lalitya12/Keus-Line-Follower-Bot/Kriti2026_Team2613_main (2).pdf

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

Kriti 2026 | Bot Design Challenge | Team ID: 2613

Executive Summary

This report presents the complete design, development, and implementation of a fully

autonomous ground rover for the Kriti 2026 Bot Design Challenge, sponsored by Keus

Smart Home. The system is engineered as a three-tier embedded architecture.

Tier 1 Arduino Uno handles real-time navigation via an eight-sensor IR array (ve

for line following, three for obstacle detection) and dual-mode obstacle avoidance (side

IRs and front IR). Tier 2 ESP32 DevModule runs a FreeRTOS dual-core percep-

tion engine managing MPU6050-based IMU-guided turning, ultrasonic radar sweep, and

camera servo positioning. Tier 3 Raspberry Pi 5 executes a ve-model machine

learning ensemble comprising YOLOv8-nano, MobileNetV3-Small embeddings, dlib face

recognition, pyzbar QR decoding, and Tesseract OCR, with results streamed in real time

to a Flask-SocketIO web dashboard.

The rover navigates a 15 ft × 20 ft oor-marked arena, follows a symmetric two-track

path with junction-aware state tracking, dynamically avoids a 250 mm cube obstacle

using gyroscope-guided 90° turns, and identies all 16 A4-format image cards. The

live operator dashboard displays camera feed, identied targets against a running 0/16

counter, timestamped logs, and a competition timer entirely over Wi-Fi, with no cloud

dependency. All computation is fully onboard.

1 | Keus Bot

## Contents

1 Problem Statement Overview | 4
2 System Architecture | 7
3 Hardware Design | 10
4 Navigation and Mobility | 15
5 Perception System | 19
6 Image Recognition Pipeline | 22

7 Communication and Web Dashboard | 25
8 Software Architecture | 27
9 System Autonomy and Execution | 29
10 Testing and Validation | 31
11 Firmware Code Walkthrough | 32
12 Conclusion | 35
A Key System Parameters | 37
B Software Requirements Files | 38

## 1 Problem Statement Overview

### 1.1 Challenge Introduction

The Kriti 2026 Bot Design Challenge requires teams to build a fully autonomous rover that navigates a predened arena while performing real-time image detection and identication without any remote control or cloud processing.

The rover must traverse a symmetric oor-marked path from point A to point B (and back in the second run), identify 16 image cards placed throughout the arena, and transmit all recognition results wirelessly to an operator laptop via a live web interface. Each team receives two attempts of up to 5 minutes; the best run is scored.

### 1.2 Arena Layout

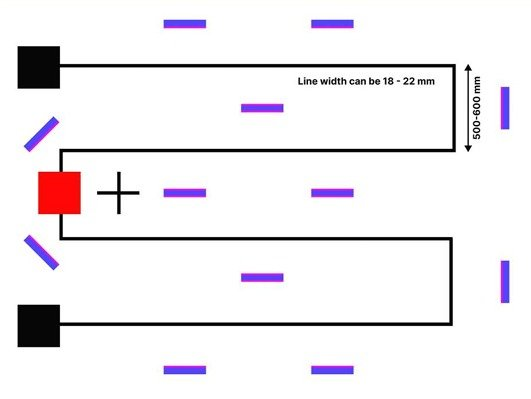
[picture p1: figure]

Figure 1. Actual arena layout (15 ft × 20 ft) Kriti 2026 Bot Design Challenge. Black path with 1822 mm line width; red obstacle (250 mm cube); purple image cards at periphery, centre corridor, and at 45° near obstacle; track segments of 500600 mm width.

### 1.3 Key Constraints

Table 1. Technical and operational constraints

Category | Constraint | Details
Technical | Max dimensions | 25 cm × 25 cm × 25 cm at all times
| Max weight | 3 kg
| Run duration | 5 minutes per run
| Power source | Onboard battery only; no external supply
O-path | Per instance | Must rejoin path within 10 seconds
| Total per run | ≤ 30 seconds o-path per run
Hardware | Controllers | Arduino, ESP32/ESP8266, Raspberry Pi only
| Forbidden | Jetson Nano, external SBCs, cloud/laptop compute
| Peripherals | Cameras, sensors, motor drivers permitted
Task | Image cards | Exactly 16; any identication order
| End condition | Reach end position after all identications

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

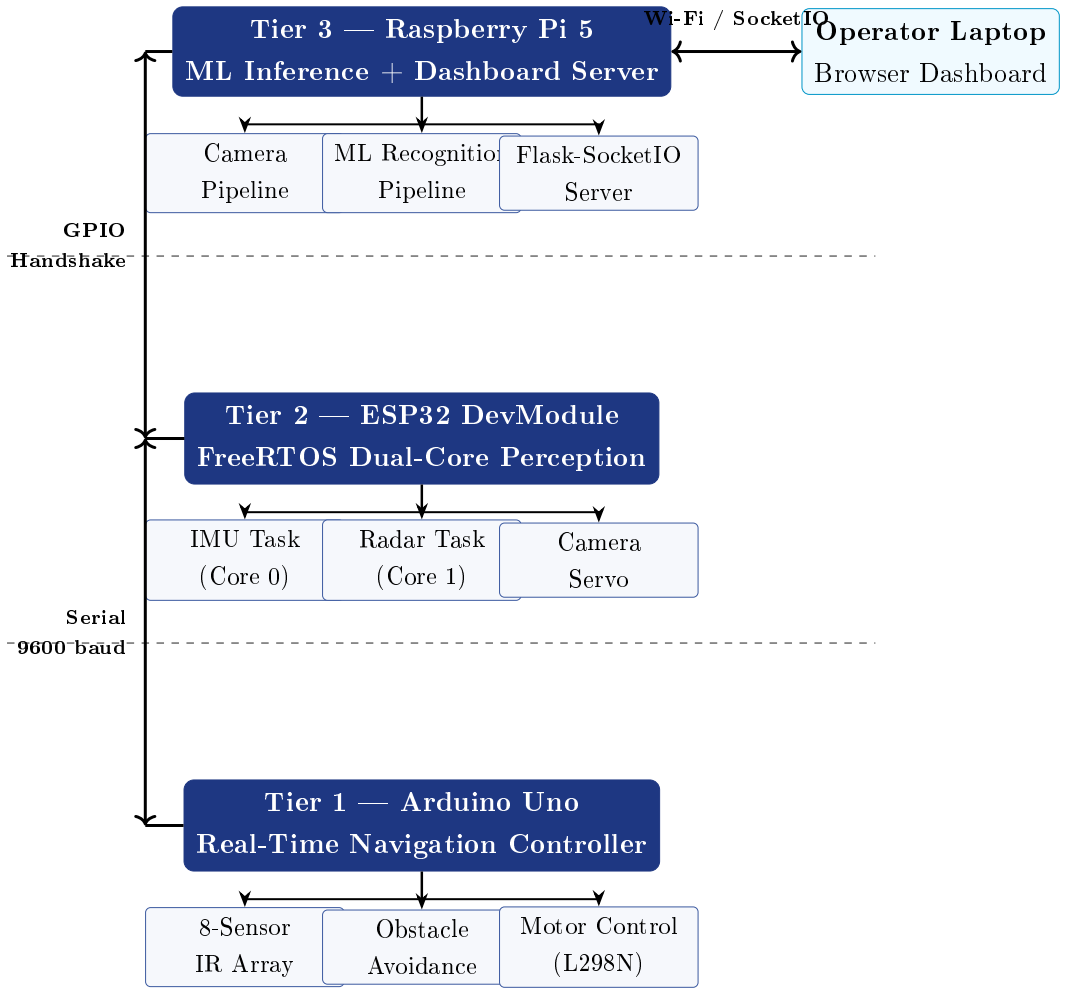
[picture p2: figure]

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

## 3 Hardware Design

### 3.1 Chassis and Mechanical Design

The rover uses a two-layer laser-cut 3 mm acrylic chassis with brass standos separating the layers for double-deck component mounting. The chassis ts within the 25 cm × 25 cm × 25 cm competition envelope at all times.

Bottom layer: DC gear motors (Ö2) with rubber wheels; array of 5 IR sen-
| sors (bottom-facing, line following); 12 V LiPo battery compartment (motor power supply).

Top layer: Arduino Uno; ESP32 DevModule; L298N motor driver; mini bread-
| boards; MPU6050 IMU module; wiring harness; power bank (RPi supply) and Li-ion 18650 cell (ESP32 supply) secured to top platform.

Servo mounts: Radar servo (30°150° sweep with front ultrasonic) and Pi Camera
| Module 3 pan servo mounted centrally on the top layer.
Front bracket: Front-facing HC-SR04 ultrasonic sensor and front IR sensor for
| obstacle detection, mounted at obstacle-detection height.
Side brackets: Left and right HC-SR04 ultrasonic sensors and side IR sensors
| (obsL, obsR) mounted on left and right anks at obstacle-detection height.

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

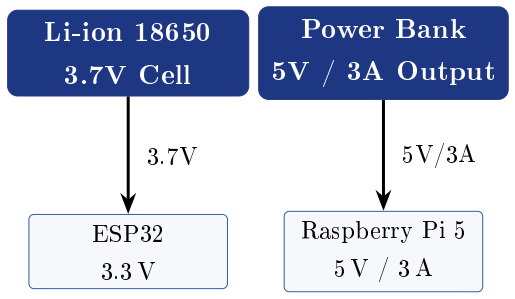
[picture p3: figure]
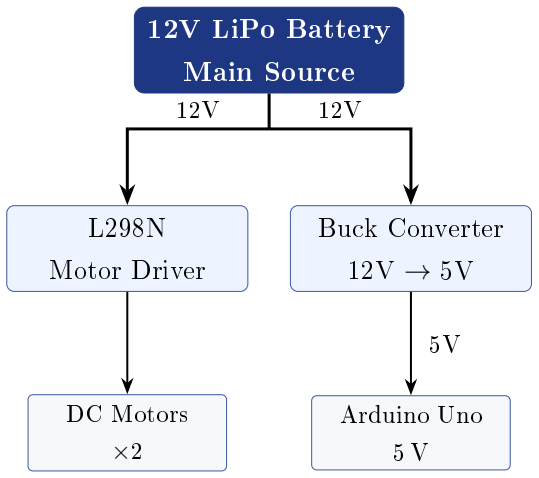
[picture p4: figure]

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

## 4 Navigation and Mobility

### 4.1 Line Following Algorithm

Five downward-facing IR sensors are arranged LL L M R RR across the path width. The Arduino evaluates them each loop iteration using a strict priority cascade: the rst matching condition determines the motor command for that cycle.

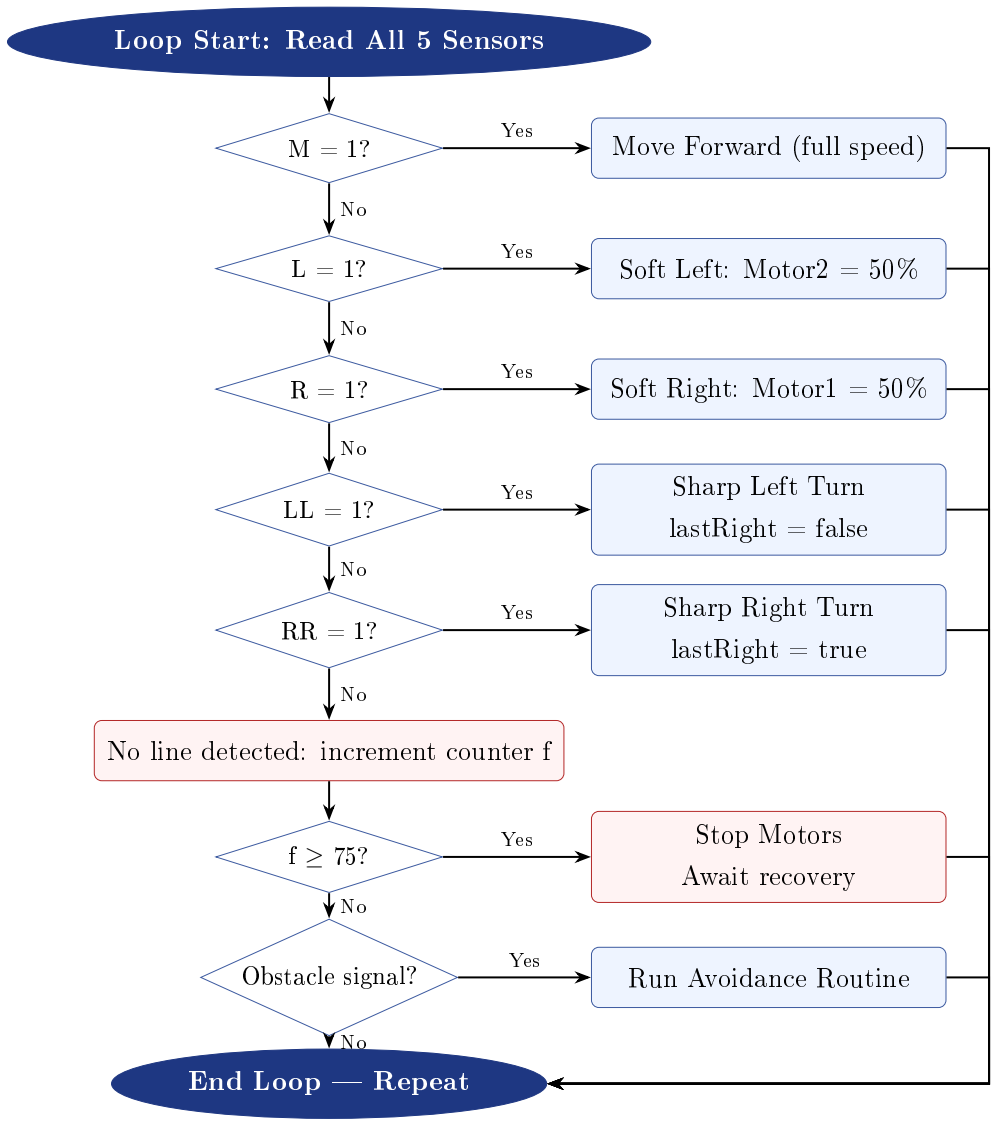
[picture p5: figure]
Loop Start: Read All 5 Sensors; No line detected: increment counter f; Obstacle signal?; End Loop  Repeat; Move Forward (full speed); Soft Left: Motor2 = 50%; Soft Right: Motor1 = 50%; Sharp Left Turn; lastRight = false; Sharp Right Turn; lastRight = true; Stop Motors; Await recovery; Run Avoidance Routine; Yes

Figure 4. Line following priority cascade with lost-line handler and obstacle check.

The lastRight ag is updated at LL/RR junctions. It stores the most recent sharpturn direction and drives all subsequent obstacle avoidance logic to ensure correct sideselection for path re-entry.

### 4.2 Obstacle Avoidance Side IR Triggered

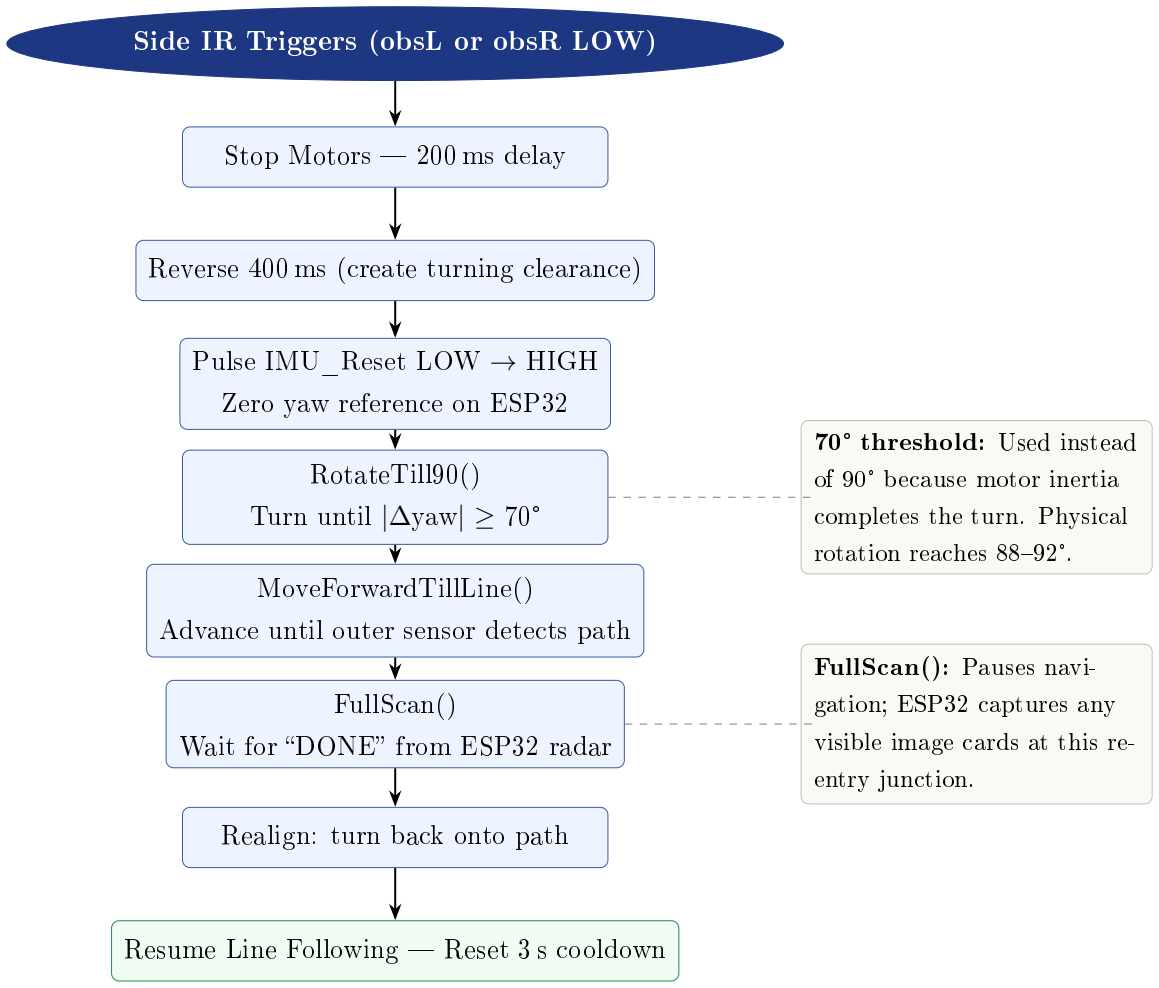
[picture p6: figure]
Side IR Triggers (obsL or obsR LOW); Stop Motors  200 ms delay; Pulse IMU_Reset LOW → HIGH; Zero yaw reference on ESP32; RotateTill90(); Turn until |∆yaw| ≥ 70°; MoveForwardTillLine(); Advance until outer sensor detects path; FullScan(); Wait for DONE from ESP32 radar; Realign: turn back onto path; threshold: Used instead; because motor inertia; completes the turn. Physical; rotation reaches 8892°.; FullScan(): Pauses navi-; gation; ESP32 captures any; visible image cards at this re-; entry junction.

Reverse 400 ms (create turning clearance)

Resume Line Following Reset 3 s cooldown

Figure 5. Side obstacle avoidance routine (obsAvoid).

### 4.3 Obstacle Avoidance Front IR Triggered

Front IR: Obstacle Detected from ESP32 Serial

Stop Motors

Turn 1: Rotate 90° in lastRight direction

Forward 1000 ms clear obstacle width

Turn 2: Rotate 90° in opposite direction

Forward 200 ms cross obstacle depth

Turn 3: Rotate 90° in opposite direction again

Forward 500 ms align with original path

MoveForwardTillLineSpecial() + FullScan()

Resume Line Following Reset 3 s cooldown

U-shape bypass sequence: Turn 1 → Forward 1 s → Turn 2 → Forward 0.2 s → Turn 3 → Forward 0.5 s. Routes the robot fully around the 250 mm cube and back onto the original path.

Figure 6. Front obstacle three-turn U-bypass routine (obsAvoidFront).

### 4.4 IMU-Guided Turning

Precise 90° turns use the MPU6050 gyroscope on the ESP32:

1. Arduino pulses IMU_Reset (A2): LOW→HIGH.
2. ESP32 Core 0 zeroes the yaw reference (resetAll).

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

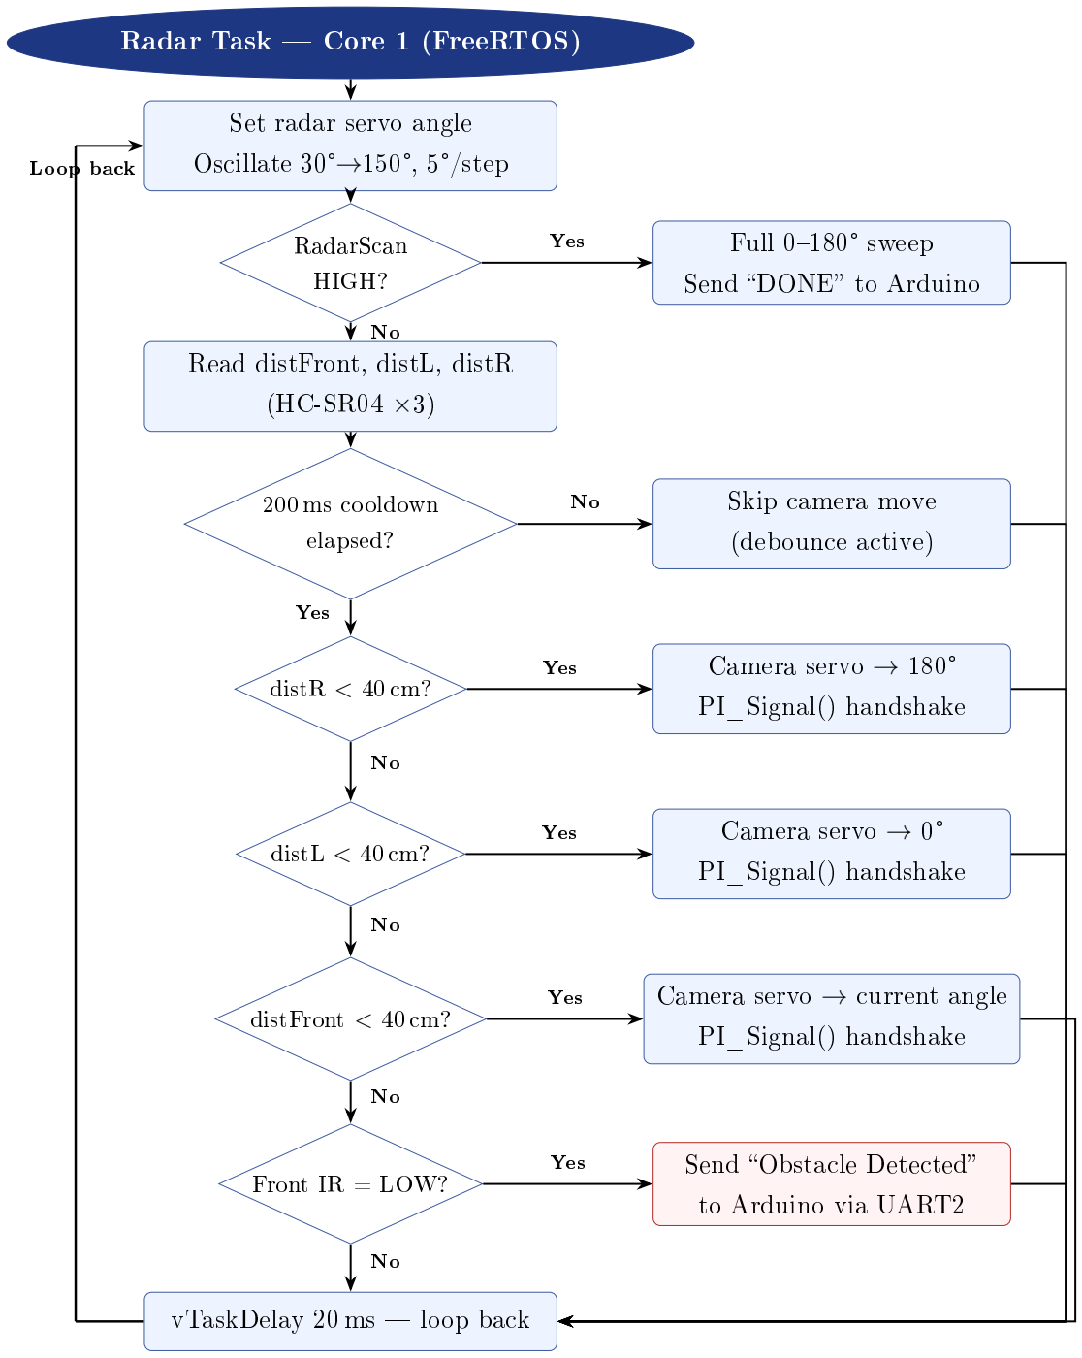
[picture p7: figure]

### 5.2 Raspberry Pi Camera Pipeline

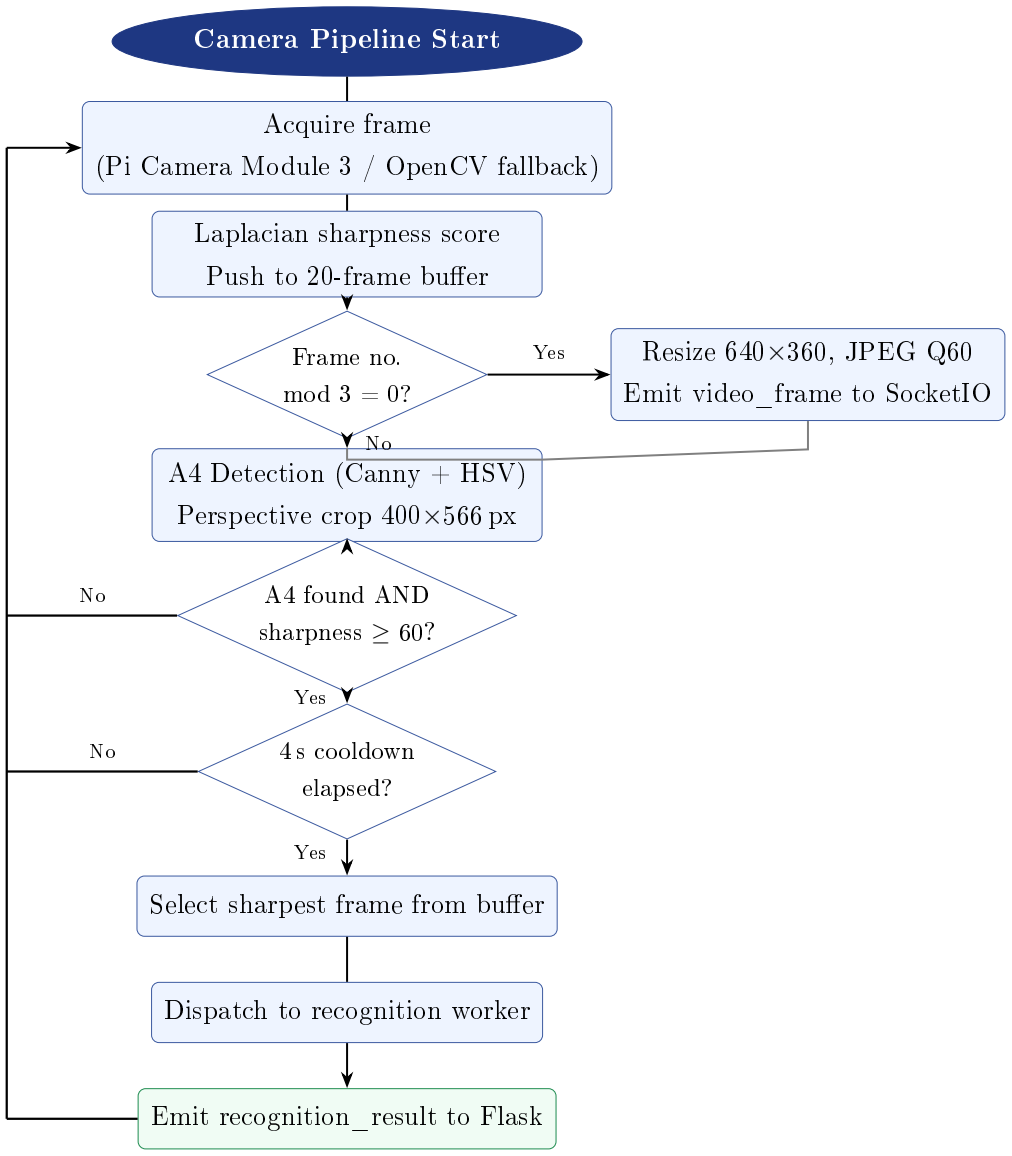
[picture p8: figure]
Camera Pipeline Start; Acquire frame; (Pi Camera Module 3 / OpenCV fallback); Laplacian sharpness score; Push to 20-frame buer; Frame no.; mod 3 = 0?; A4 Detection (Canny + HSV); Perspective crop 400×566 px; A4 found AND; sharpness ≥ 60?; 4 s cooldown; elapsed?; Select sharpest frame from buer; Dispatch to recognition worker; Emit recognition_result to Flask; Resize 640×360, JPEG Q60; Emit video_frame to SocketIO; Yes

Figure 8. Raspberry Pi camera pipeline (camera_pipeline.py).

### 5.3 A4 Detection and Perspective Correction

Two parallel detection methods run on every frame:

1. Canny method: Gaussian blur → Canny edges (40/130) → dilation → contour
| nd.
2. HSV white method: Convert HSV → threshold (H:0180, S:050, V:140255)
| → morphological close → contour nd.

Both apply: 4-corner polygon, area 1092%, aspect ratio 1.12.0, mean brightness ≥140.

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

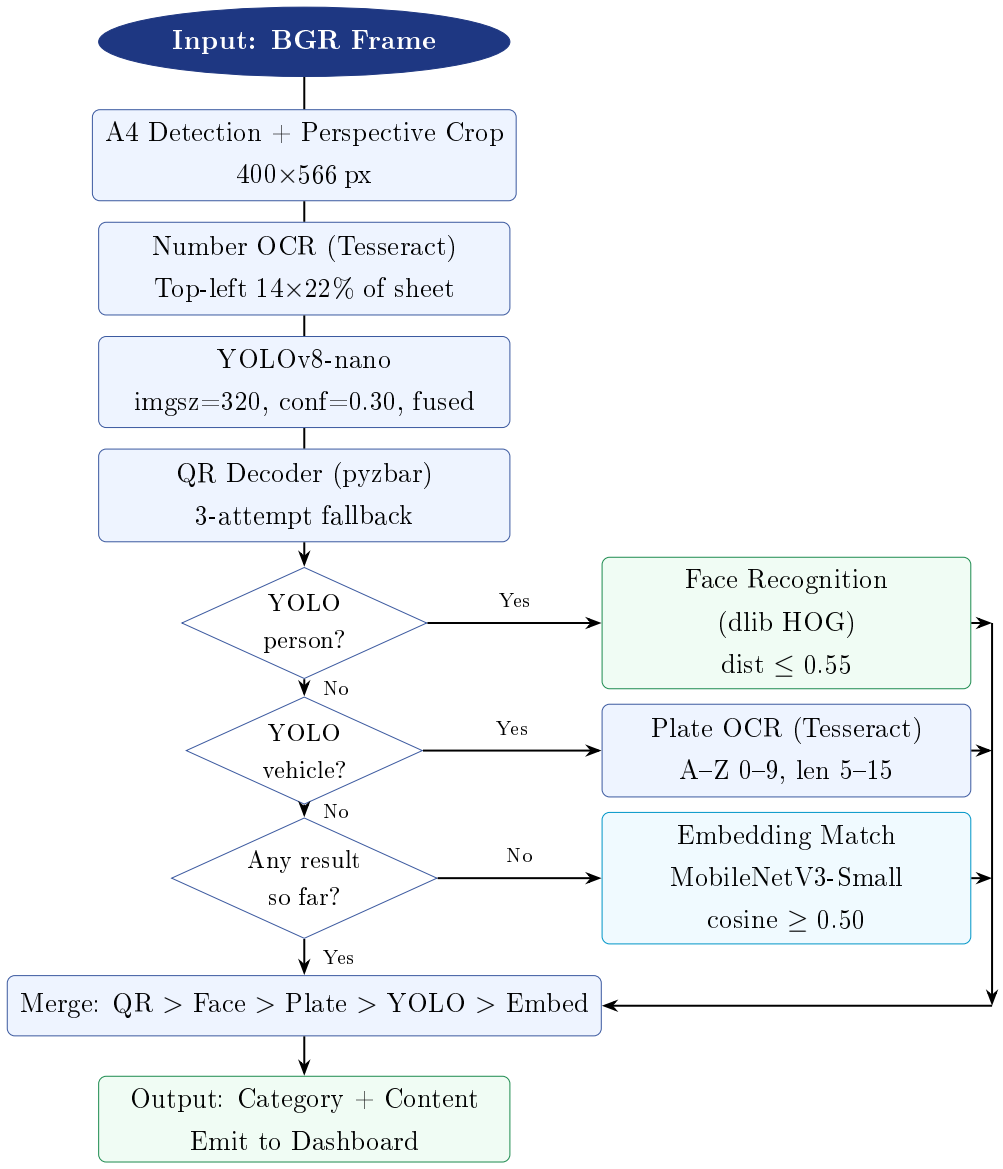
[picture p9: figure]

6.2 | Detection Methods
6.2.1 | YOLOv8-nano Object Detection

Table 8. YOLO COCO class mapping to competition categories

COCO Class | Competition Category | Competition Content
car | Vehicle | Car
truck | Vehicle | Truck
bus | Vehicle | Bus
bicycle | Vehicle | Bicycle
motorcycle | Vehicle | Motorbike
cat | Pets | Cat
dog | Pets | Dog
chair | Furniture | Chair
couch | Furniture | Sofa
bed | Furniture | Bed
dining table | Furniture | Dining Table
suitcase | Parcel | Parcel
person | (special) | Triggers face recognition pipeline
6.2.2 | MobileNetV3-Small Embedding Matcher

A 576-dimensional embedding is extracted and L2-normalised. Cosine similarity is computed against a pre-built reference database. Match threshold: ≥ 0.50. Fine-tuned weights (mobilenet_finetuned.pth) are loaded preferentially if present.

6.2.3 Face Recognition

Three identities in face_encodings.pkl: Henry Cavill, Keanu Reeves, Roger Federer. dlib HOG detector locates faces; 128-dim encodings compared at threshold ≤ 0.55. Images downscaled to max 500 px for fast detection.

6.2.4 QR Decoder

pyzbar attempts decoding on: original → grayscale → Otsu-thresholded. QR results carry condence 1.0 and highest merge priority.

6.2.5 OCR Engine

Tesseract (≈70 ms) is primary; PaddleOCR (≈1200 ms) is fallback. Plate validation: contains both letters and digits, length 515, ≥80% alphanumeric.

### 6.3 Performance Summary

Table 9. Recognition pipeline performance on Raspberry Pi 5

Stage | Typical Time | Notes
A4 Detection | ∼30 ms | Dual-method; every frame
Number OCR (Tesseract) | ∼70 ms | Top-left region only (≈14% of sheet)
YOLOv8-nano | ∼200 ms | imgsz=320; fused layers
QR Decode | <10 ms | Instant; every recognition call
Face Recognition | ∼300 ms | HOG, downscaled; conditional on person
Plate OCR | ∼100 ms | Tesseract; conditional on vehicle
Embedding Match | ∼50 ms | DB dot-product; last resort only
Total (typical) | 700 ms1.5 s | Target: ≤ 2 s per card

## 7 Communication and Web Dashboard

### 7.1 Flask-SocketIO Backend

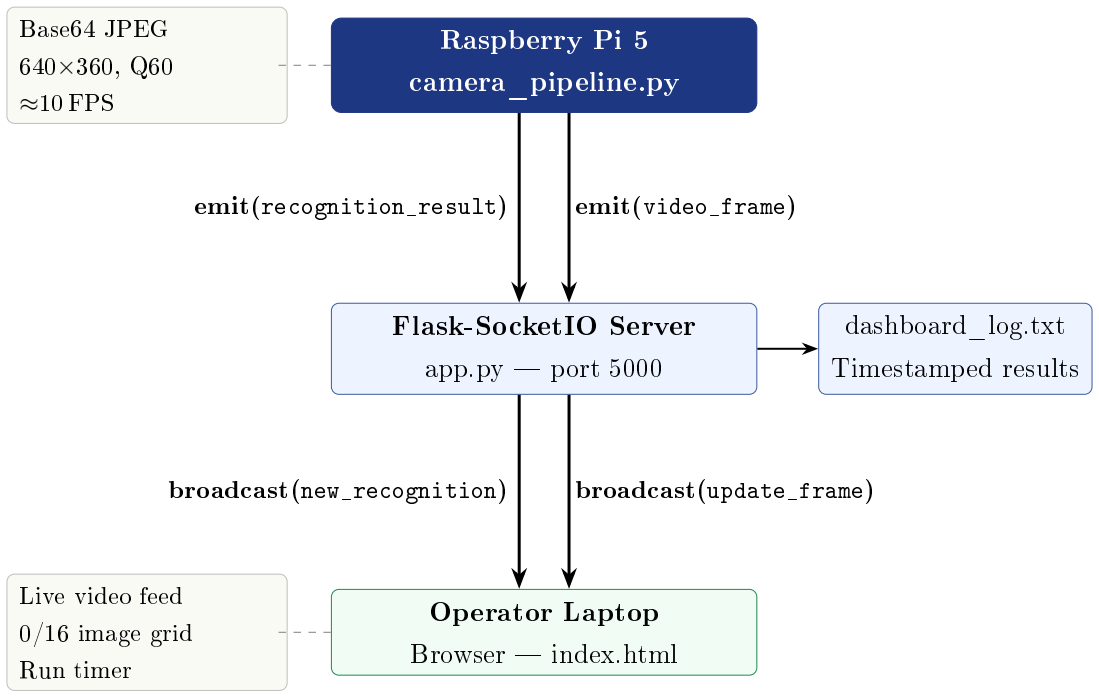
[picture p10: figure]
Raspberry Pi 5; camera_pipeline.py; Flask-SocketIO Server; app.py  port 5000; Operator Laptop; Browser  index.html; emit(recognition_result); emit(video_frame); broadcast(new_recognition); broadcast(update_frame); dashboard_log.txt; Timestamped results; Base64 JPEG; ≈10 FPS; Live video feed; 0/16 image grid; Run timer

Figure 10. Flask-SocketIO event ow from camera pipeline to operator dashboard.

Key design decisions:

max_http_buffer_size=1e8 handles continuous base64 frame payloads without dropping.
cors_allowed_origins="*" allows connection from any IP on the competition network.
All recognition results are written to dashboard_log.txt with timestamps veriable by judges.
Video compressed to 640×360 at JPEG quality 60, reducing bandwidth while maintaining clarity.

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

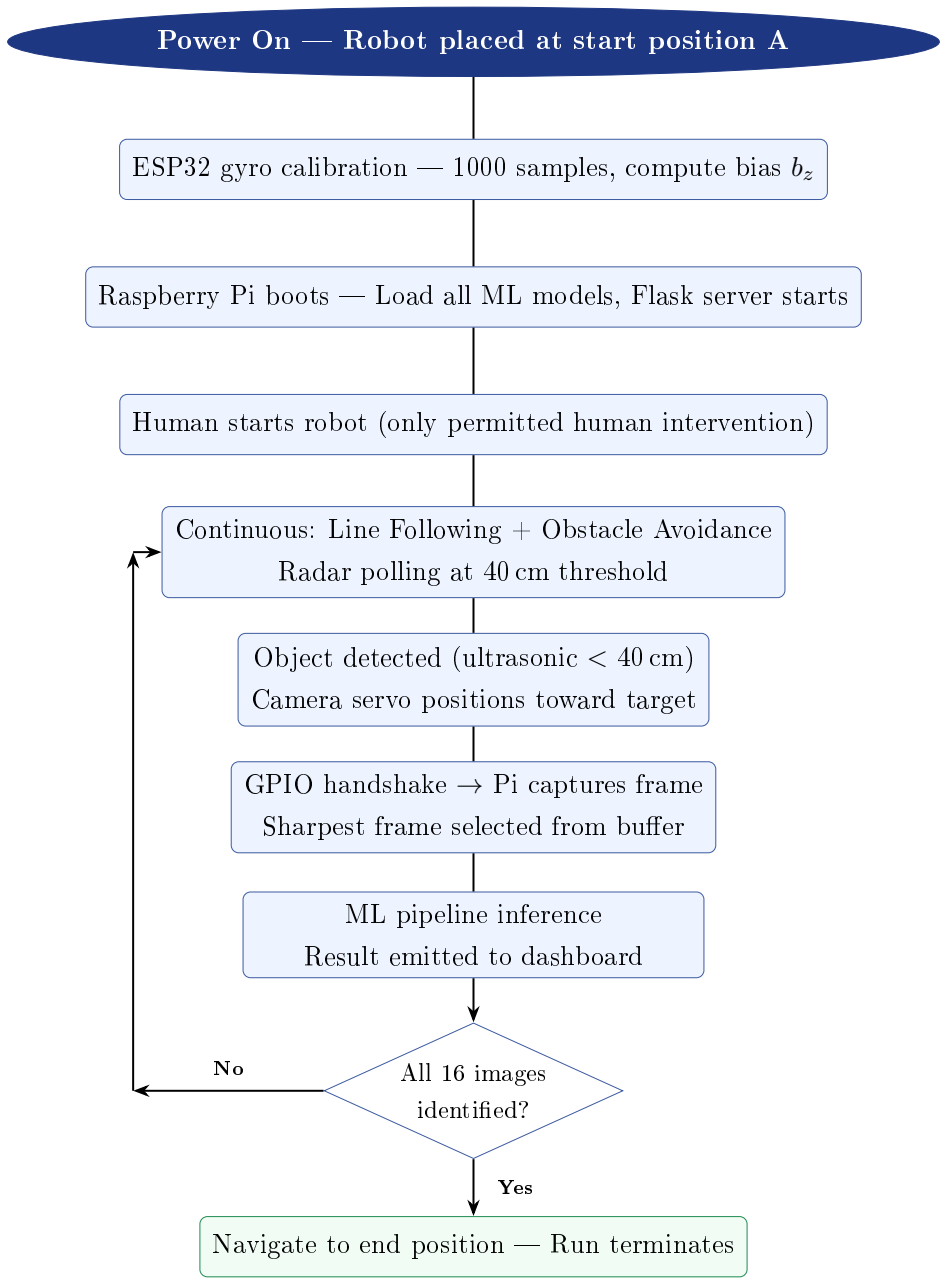
[picture p11: figure]

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

## 10 Testing and Validation

### 10.1 Firmware Testing

Line following veried on 1822 mm black tape; all 5 sensor states conrmed indi-
| vidually and in combination.
IMU turn precision: 70° threshold consistently yields 8892° physical rotation.
Side and front obstacle avoidance tested with a 250 mm cube at various path po-
| sitions.
3-second cooldown conrmed to prevent re-trigger oscillation post-recovery.

### 10.2 Vision System Testing

A4 detection validated under normal indoor lighting; lters eectively reject false
| positives.
Perspective correction produces consistent 400×566 px crops across varied viewing
| angles and distances.
Full ML pipeline tested in test-folder mode against representative image sam-
| ples.
mock_rover.py used to validate all dashboard behaviour without the physical
| robot.
10.3 | Dashboard Testing

SocketIO connection conrmed stable on local Wi-Fi at ≈10 FPS video. Recognition results correctly populate the 0/16 target grid.
Timer and log events veried on START/STOP sequences.

## 11 Firmware Code Walkthrough

This section provides a concise step-by-step walkthrough of both rmware les RoboKriti.ino (Arduino Uno) and ESP.ino (ESP32 DevModule) explaining how each executes during a competition run.

### 11.1 Arduino Uno RoboKriti.ino

1. Initialisation (setup()). All sensor pins (ve line-following IR sensors, two side
| obstacle IRs, one front IR on ESP32 GPIO14), motor driver pins (L298N), and communication pins (IMU_Reset, RadarScan, SoftwareSerial on D2/D3) are con- gured. Both motor outputs are stopped and the control pins are driven LOW.
2. Main loop sensor read. Each iteration reads all ve line sensors (LL, L, M,
| R, RR) and prints their states to the hardware serial monitor for debugging.
3. Priority-cascade line following. The sensor states are evaluated in strict pri-
| ority order: centre (M) → soft-left (L) → soft-right (R) → sharp-left (LL) → sharp-right (RR). The rst matching condition sets the motor speeds for that cy- cle. LL/RR hits also update the lastRight junction ag.
4. Lost-line handler. If no sensor detects the line, a counter f increments on each
| loop tick. Once f reaches 160 (≈ 3 s), the motors stop and await recovery.
5. Obstacle cooldown gate. All obstacle-avoidance logic is gated behind a 3 s
| cooldown (millis() - lastAvoidTime > 3000) to prevent re-trigger oscillation immediately after a recovery manoeuvre.
6. Front obstacle avoidance (obsAvoidFront). If the ESP32 sends an "Obstacle
| Detected" message over SoftwareSerial, the robot stops, then executes a three- turn U-bypass: rotate 90° in lastRight direction → forward 1 s → rotate 90° opposite → forward 2.3 s → rotate 90° opposite again → forward 0.5 s, then calls MoveForwardTillLineSpecial() to re-acquire the path.
7. Side obstacle avoidance (obsAvoid). If either side IR (obsL or obsR) goes
| LOW, the robot stops, reverses briey for turning clearance, pulses IMU_Reset to zero the ESP32 yaw reference, calls RotateTill90() to rotate 90° using live gyroscope feedback, then calls MoveForwardTillLine() to advance until the outer line sensor detects the path, followed by a FullScan() radar trigger and path realignment.
8. IMU-guided turning (RotateTill90). A LOW→HIGH pulse on IMU_Reset zeroes the ESP32 yaw reference. The Arduino then polls ReadYaw() over SoftwareSerial and drives the motors until |∆yaw| ≥ 70; motor inertia completes the remaining ≈20°, yielding a physical 8892° turn.
9. Radar trigger (FullScan). RadarScan is driven HIGH; the Arduino waits up to 5 s for a "DONE" acknowledgement from the ESP32 before driving it LOW again, ensuring a complete 0180° ultrasonic sweep at every path re-entry point.

### 11.2 ESP32 DevModule ESP.ino

1. Initialisation (setup()). UART2 (GPIO16/17) is opened at 9600 baud for Ar-
| duino communication. Both servo objects (radarServo, cameraServo) are at- tached. All ultrasonic trigger/echo pins (front/left/right HC-SR04s), front IR sen- sor (GPIO14), GPIO handshake pins (toPI, fromPI), and trigger input pins are congured. The MPU6050 is initialised over I²C.
2. Gyroscope bias calibration. 1000 raw gyro-Z samples are collected at 2 ms
| intervals and averaged to compute gyroBiasZ, which is subtracted from every subsequent gyro reading to eliminate static drift.
3. FreeRTOS task launch. Two tasks are pinned to separate cores: the IMU task
| on Core 0 and the Radar task on Core 1, enabling true parallel execution.
4. IMU task Core 0 (imu). Monitors TRIGGER_PIN (Arduino IMU_Reset)
| for a LOW→HIGH edge. On detection, resetAll() zeroes the angle accumu- lators and startTracking() enables continuous IMU integration. While tracking, readIMU() integrates gyro-Z with a complementary lter (α = 0.9) and streams "IMU:<angle>" to the Arduino at ≈50 Hz. Tracking stops on a HIGH→LOW edge.
5. Radar task Core 1 (radar). The radar servo oscillates between 30° and 150°
| in 5° steps with a 20 ms vTaskDelay per step. On each step: If TRIGGERC_PIN (Arduino RadarScan) goes HIGH, a full 0180° sweep() is executed and "DONE" is sent to the Arduino. All three ultrasonic distances (front, left, right) are read. If any distance is < 40 cm and the 200 ms camera cooldown has elapsed, the camera servo is pointed toward the detected side (0°, 90°, or 180°) and PI_Signal() triggers a Raspberry Pi image capture. The front IR sensor is checked; a LOW reading sends "Obstacle Detected" to the Arduino over UART2.
6. GPIO handshake with Raspberry Pi (PI_Signal). toPI is driven HIGH; the

ESP32 waits up to 1 s for fromPI to go HIGH (acknowledgement from Pi), then drives toPI LOW. This ensures the Pi has conrmed the capture request before the radar task continues.

7. Full sweep (sweep). The radar servo sweeps 0°→180°→0° in 5° steps, printing any detected object angles (< 40 cm) to the serial monitor, then transmits "DONE" to the Arduino to release the FullScan() wait.

## 12 Conclusion

Team 2613 has designed and implemented a complete autonomous rover system addressing all nine evaluation parameters of the Kriti 2026 Bot Design Challenge. The three-tier architecture cleanly separates real-time navigation (Arduino Uno), parallel perception (ESP32 DevModule), and ML inference (Raspberry Pi 5), allowing each tier to operate at its optimal performance without blocking the others.

The system demonstrates robust engineering across the full stack: gyroscope-guided precision turning with startup bias calibration, dual-mode obstacle avoidance with stateaware path recovery, a ve-model conditional ML ensemble targeting under 2 s inference per card, and a real-time web dashboard providing complete operator visibility during competition runs.

The governing design philosophy is reliability over complexity: conservative thresholds, cooldown timers, sensor fusion, and multi-level fallback chains ensure the robot behaves predictably and consistently across both competition runs.

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
